klavinslab/Flexostat-hardware-firmware/README.md

# The project has moved to it's own [github page](https://github.com/flexostat ).

Please visit https://github.com/flexostat for the latest designs.

Image of Yaktocat
