klavinslab/Flexostat-hardware-firmware/led_board/seeed_BOM_File.csv

Part/Designator | Manufacture Part Number/Seeed SKU | Quantity
C1 | 0100440P1 | 1
J1 | 3420050P1 | 1
J2 | 3460650P1 | 1
ISP J5 | 3460180P1 | 2
J4 | 3460810P1 | 1
Q1 Q2 Q3 Q4 | 0440200P1 | 2
R2 R3 R4 | 301010293 | 3
U1 | 1030060P1 | 1
U2 | 310040018 | 1
D1 D2 D3 D4 D5 D6 D7 D8 | 0300040P1 | 8
