klavinslab/Flexostat-hardware-firmware/led_board/PCB_assembly_jig.stl

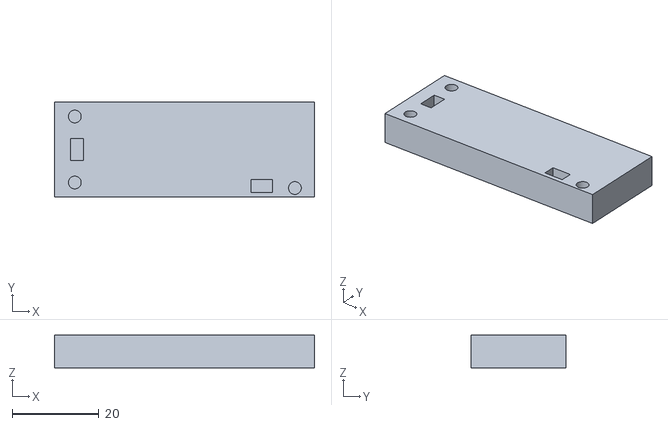
[picture p1: CAD file, 2015-09-08]
led_board/PCB_assembly_jig.stl
60.0 x 22.0 x 7.60
