klavinslab/Flexostat-hardware-firmware/chamber/chamber_25mm_tube_fan_mount.stl

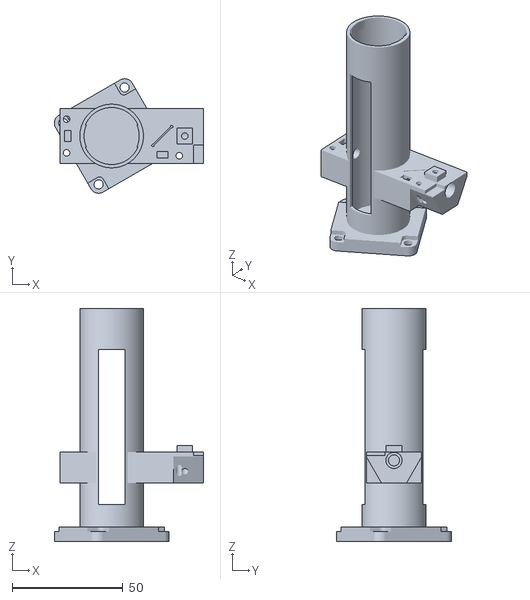
[picture p2: CAD file, 2015-09-30]
chamber/chamber_25mm_tube_fan_mount.stl
67.3 x 51.7 x 105.1
