klavinslab/Flexostat-hardware-firmware/mount/mount_plate.dxf

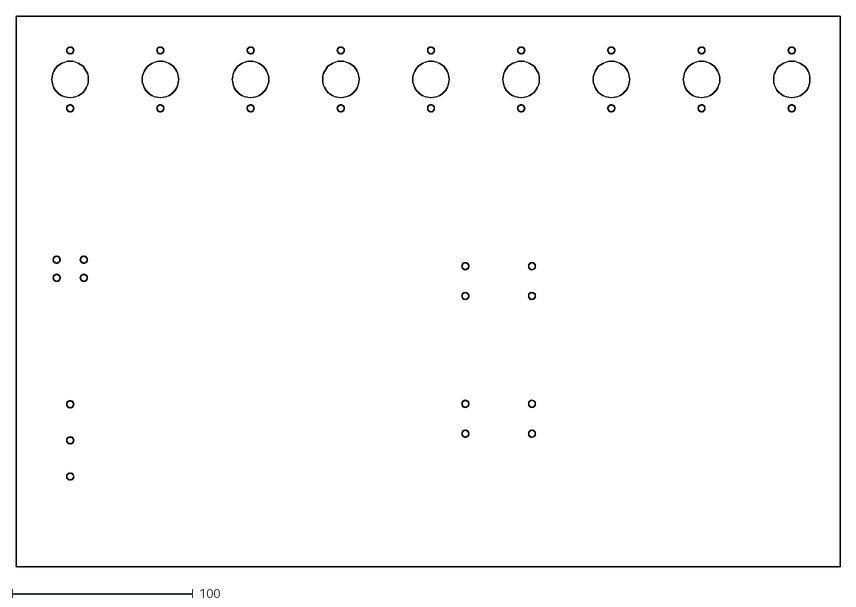
[picture p3: CAD file, 2015-09-30]
mount/mount_plate.dxf
456.0 x 304.8
