klavinslab/Flexostat-hardware-firmware/pinchvalve/Source/center_adapter.stp

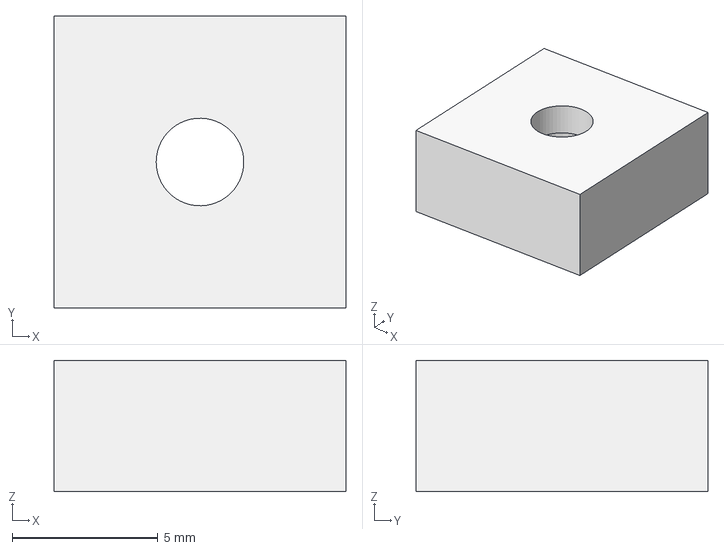
[picture p4: CAD file, 2014-01-11]
pinchvalve/Source/center_adapter.stp
10.0 x 10.0 x 4.50 mm
