klavinslab/Flexostat-hardware-firmware/stopper_mold/mold_part_1.stl

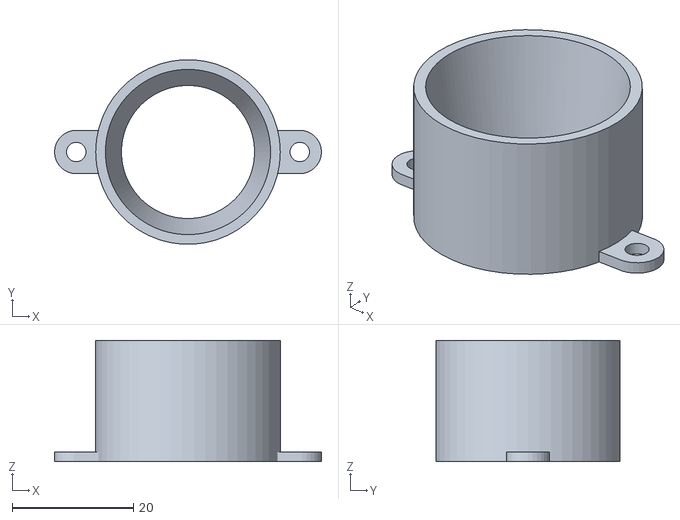
[picture p5: CAD file, 2015-09-30]
stopper_mold/mold_part_1.stl
44.0 x 30.3 x 20.0
