klavinslab/Flexostat-hardware-firmware/syringe_pump/Source/syringe_mount.stp

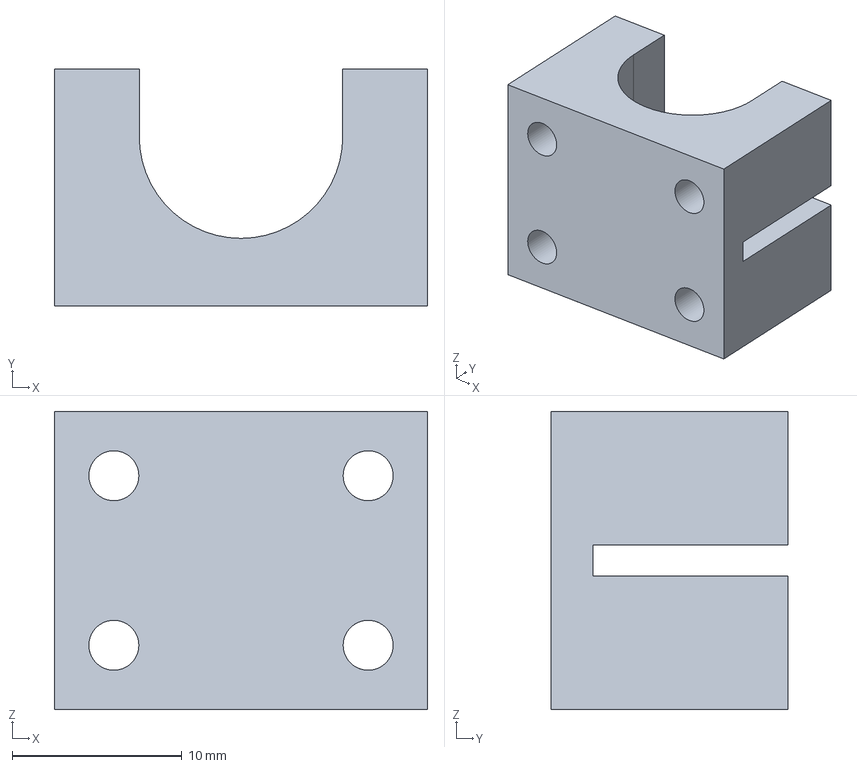
[picture p6: CAD file, 2015-04-14]
syringe_pump/Source/syringe_mount.stp
22.0 x 14.0 x 17.6 mm
