klavinslab/Flexostat-hardware-firmware/chamber/fan_magnet_holder.stl

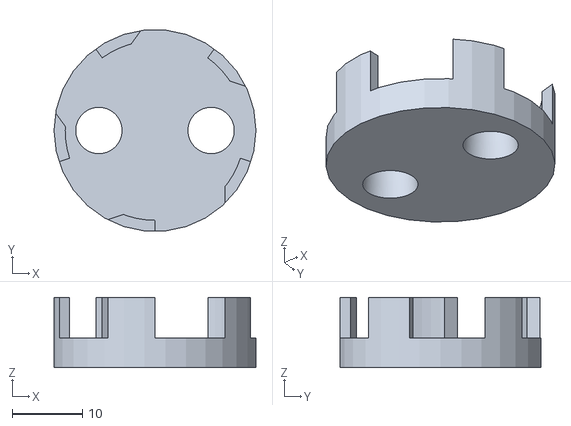
[picture p7: CAD file, 2015-09-08]
chamber/fan_magnet_holder.stl
28.8 x 28.6 x 10.0
