klavinslab/Flexostat-hardware-firmware/pinchvalve/Source/holder.stp

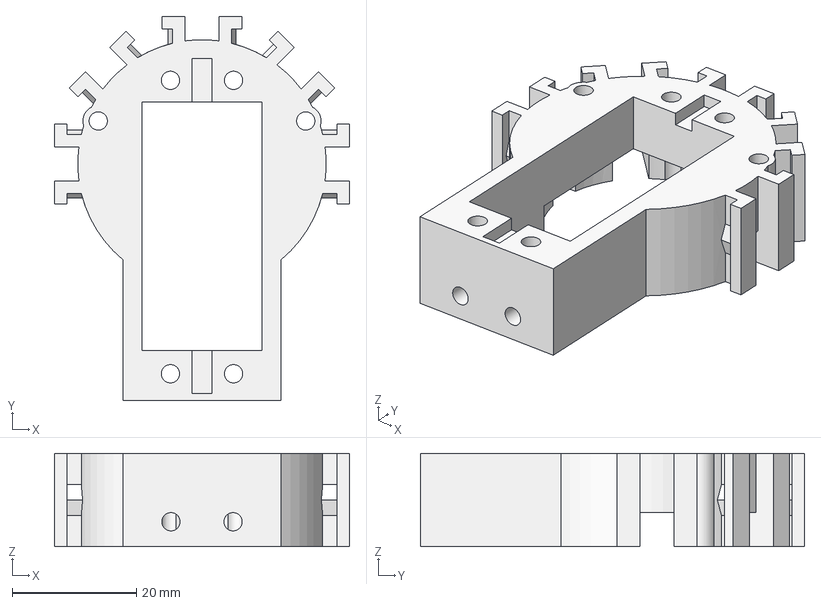
[picture p8: CAD file, 2014-01-11]
pinchvalve/Source/holder.stp
47.5 x 61.9 x 15.0 mm
