klavinslab/Flexostat-hardware-firmware/stopper_mold/mold_part_2.stl

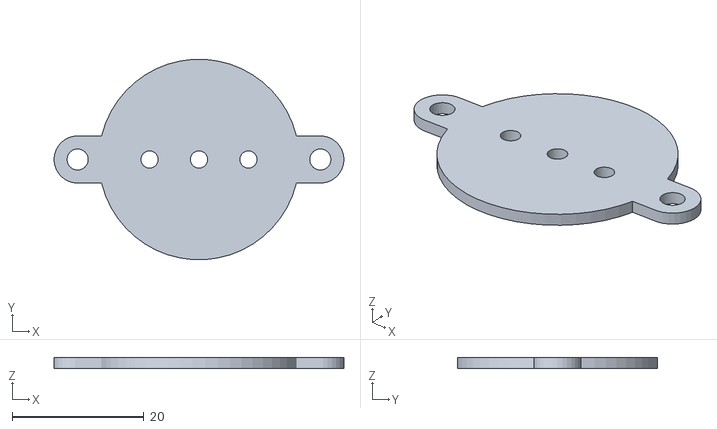
[picture p9: CAD file, 2015-09-30]
stopper_mold/mold_part_2.stl
44.0 x 30.3 x 1.60
