klavinslab/Flexostat-hardware-firmware/syringe_pump/Source/holder.stp

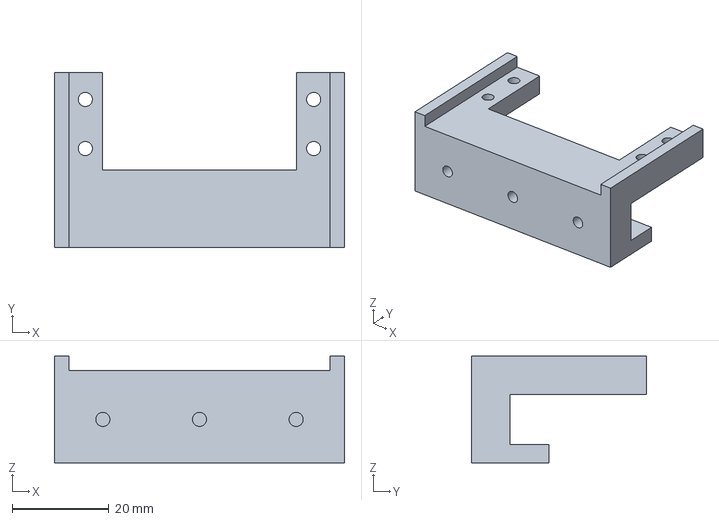
[picture p10: CAD file, 2014-08-07]
syringe_pump/Source/holder.stp
60.0 x 36.3 x 22.1 mm
