klavinslab/Flexostat-hardware-firmware/chamber/chamber_25mm_tube.stl

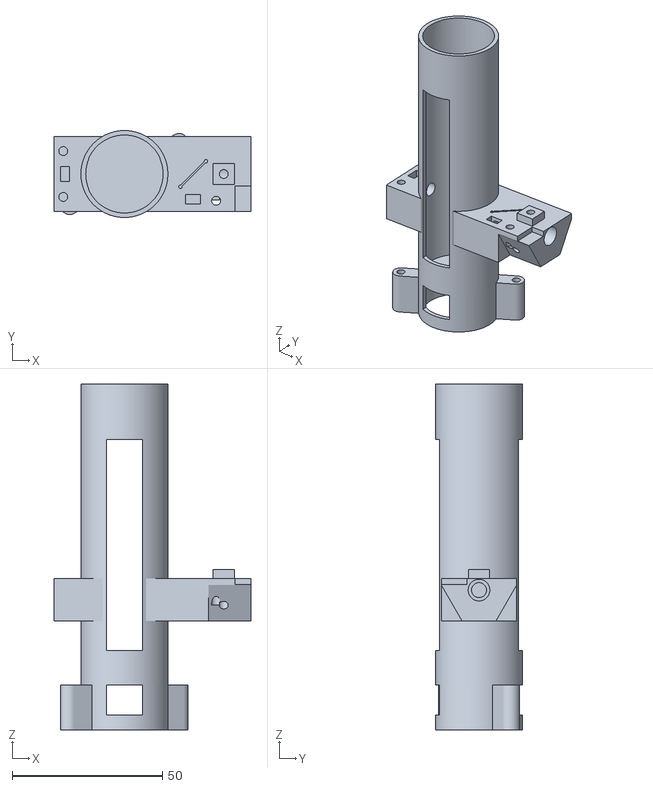
[picture p11: CAD file, 2015-08-22]
chamber/chamber_25mm_tube.stl
65.3 x 28.9 x 115.0
