klavinslab/Flexostat-hardware-firmware/pinchvalve/Source/valve_clip_1_50.stp

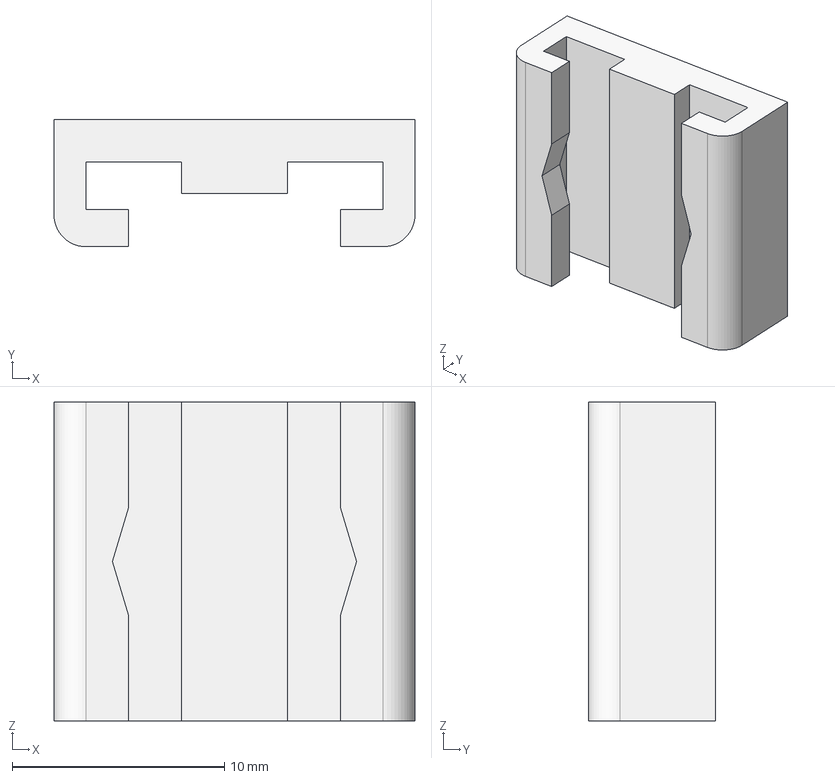
[picture p12: CAD file, 2014-01-11]
pinchvalve/Source/valve_clip_1_50.stp
17.0 x 6.00 x 15.0 mm
