klavinslab/Flexostat-hardware-firmware/stopper_mold/mold_part_3.stl

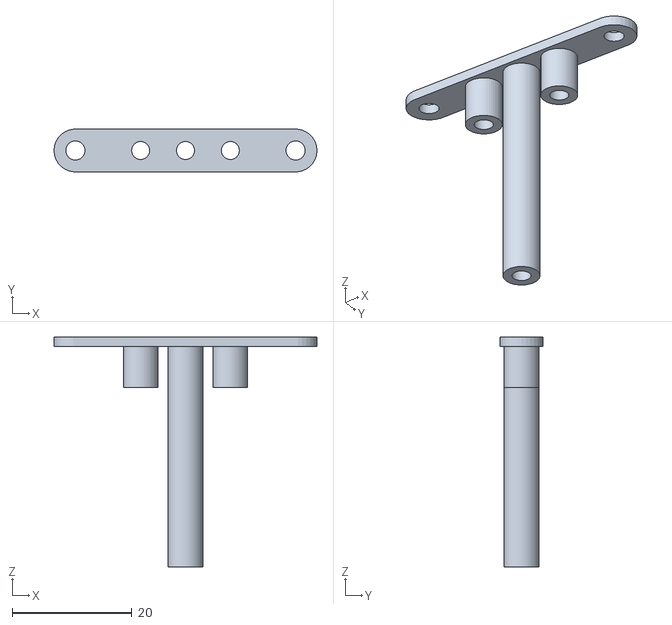
[picture p13: CAD file, 2015-09-30]
stopper_mold/mold_part_3.stl
44.0 x 7.12 x 38.4
