klavinslab/Flexostat-hardware-firmware/syringe_pump/Source/syringe_mount_top.stp

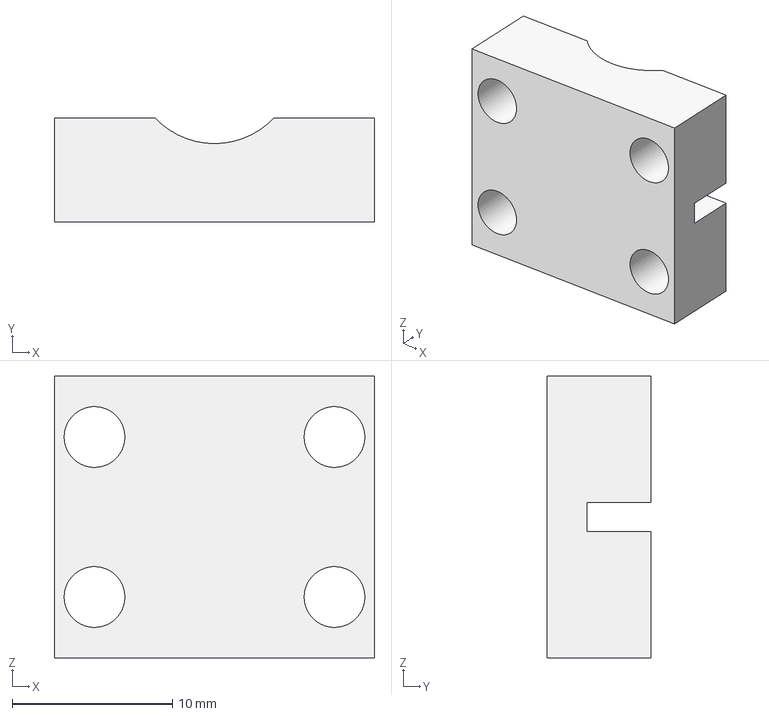
[picture p14: CAD file, 2014-01-11]
syringe_pump/Source/syringe_mount_top.stp
20.0 x 6.50 x 17.6 mm
