klavinslab/Flexostat-hardware-firmware/chamber/magnet_holder.stl

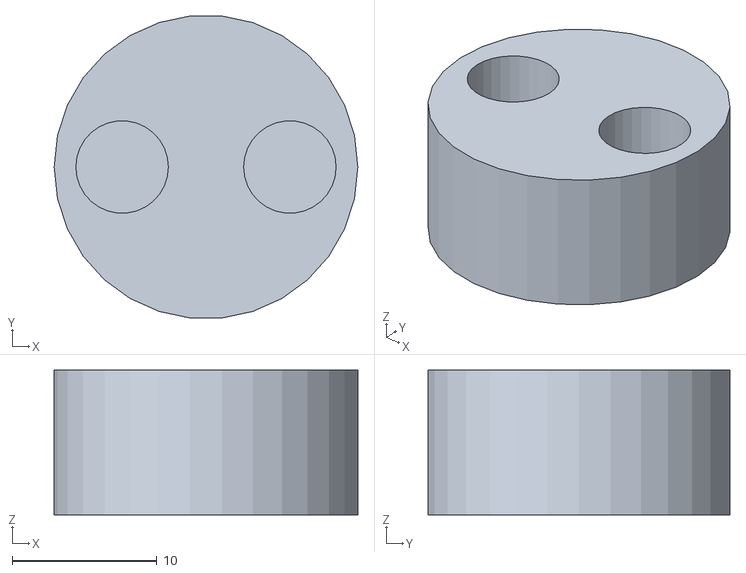
[picture p15: CAD file, 2015-08-22]
chamber/magnet_holder.stl
21.0 x 20.9 x 10.0
