klavinslab/Flexostat-hardware-firmware/stopper_mold/rubber_stopper_mold_part_AB.stl

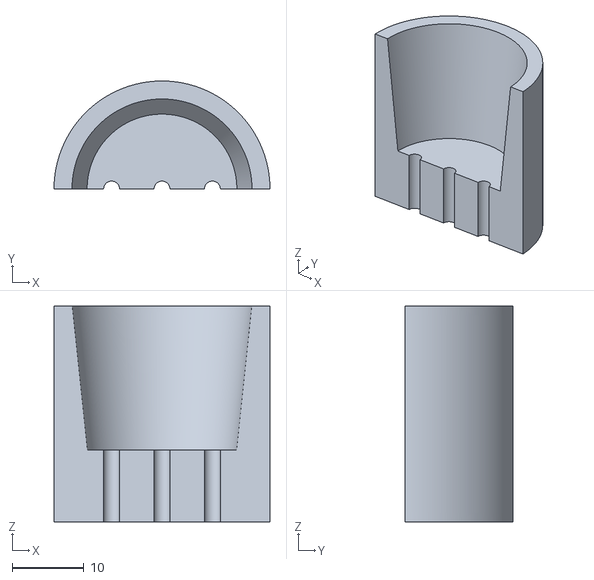
[picture p16: CAD file, 2014-11-18]
stopper_mold/rubber_stopper_mold_part_AB.stl
30.0 x 15.0 x 30.0
