klavinslab/Flexostat-hardware-firmware/syringe_pump/Source/slide.stp

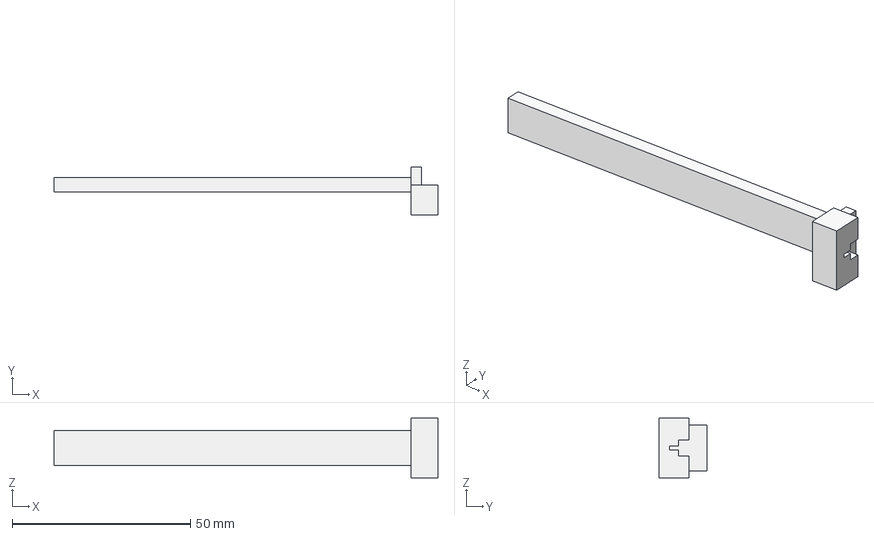
[picture p17: CAD file, 2014-01-11]
syringe_pump/Source/slide.stp
107.6 x 13.5 x 16.8 mm
