klavinslab/Flexostat-hardware-firmware/chamber/chamber_24mm_tube.stl

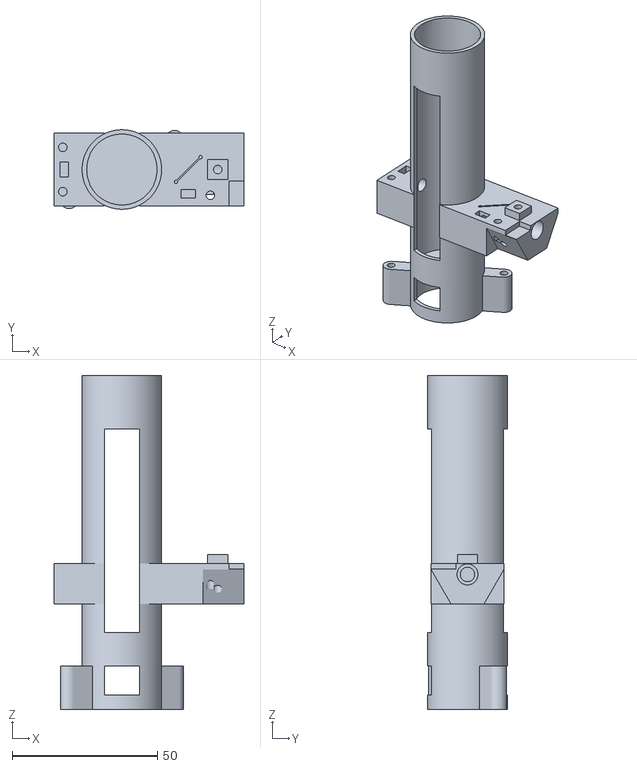
[picture p18: CAD file, 2015-08-22]
chamber/chamber_24mm_tube.stl
65.3 x 27.4 x 115.0
