klavinslab/Flexostat-hardware-firmware/stopper_mold/rubber_stopper_mold.stl

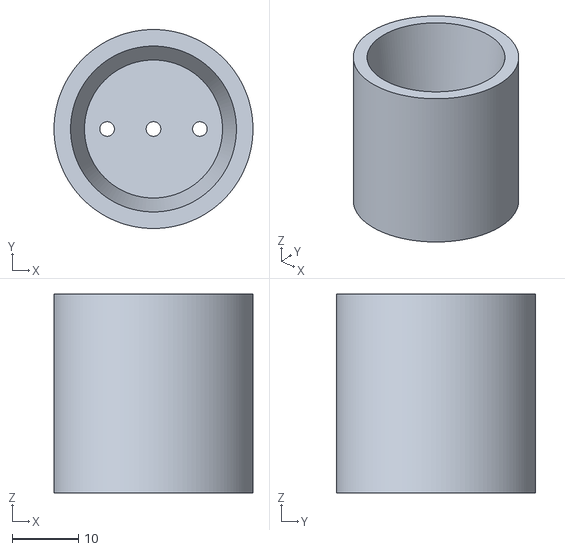
[picture p19: CAD file, 2014-01-11]
stopper_mold/rubber_stopper_mold.stl
30.0 x 30.0 x 30.0
