klavinslab/Flexostat-hardware-firmware/(list of files, cad)

Other CAD files:
pinchvalve/Source/valve_clip_2_00.stp
pinchvalve/Source/valve_clip_1_75.stp
chamber/source/PCB_assembly_jig.scad
pinchvalve/center_adapter.stl
pinchvalve/holder.stl
pinchvalve/valve_clip_1_50.stl
pinchvalve/valve_clip_1_75.stl
pinchvalve/valve_clip_2_00.stl
syringe_pump/holder.stl
syringe_pump/slide.stl
syringe_pump/syringe_mount.stl
syringe_pump/syringe_mount_top.stl
