klavinslab/Flexostat-hardware-firmware/mount/MP drawing.pdf

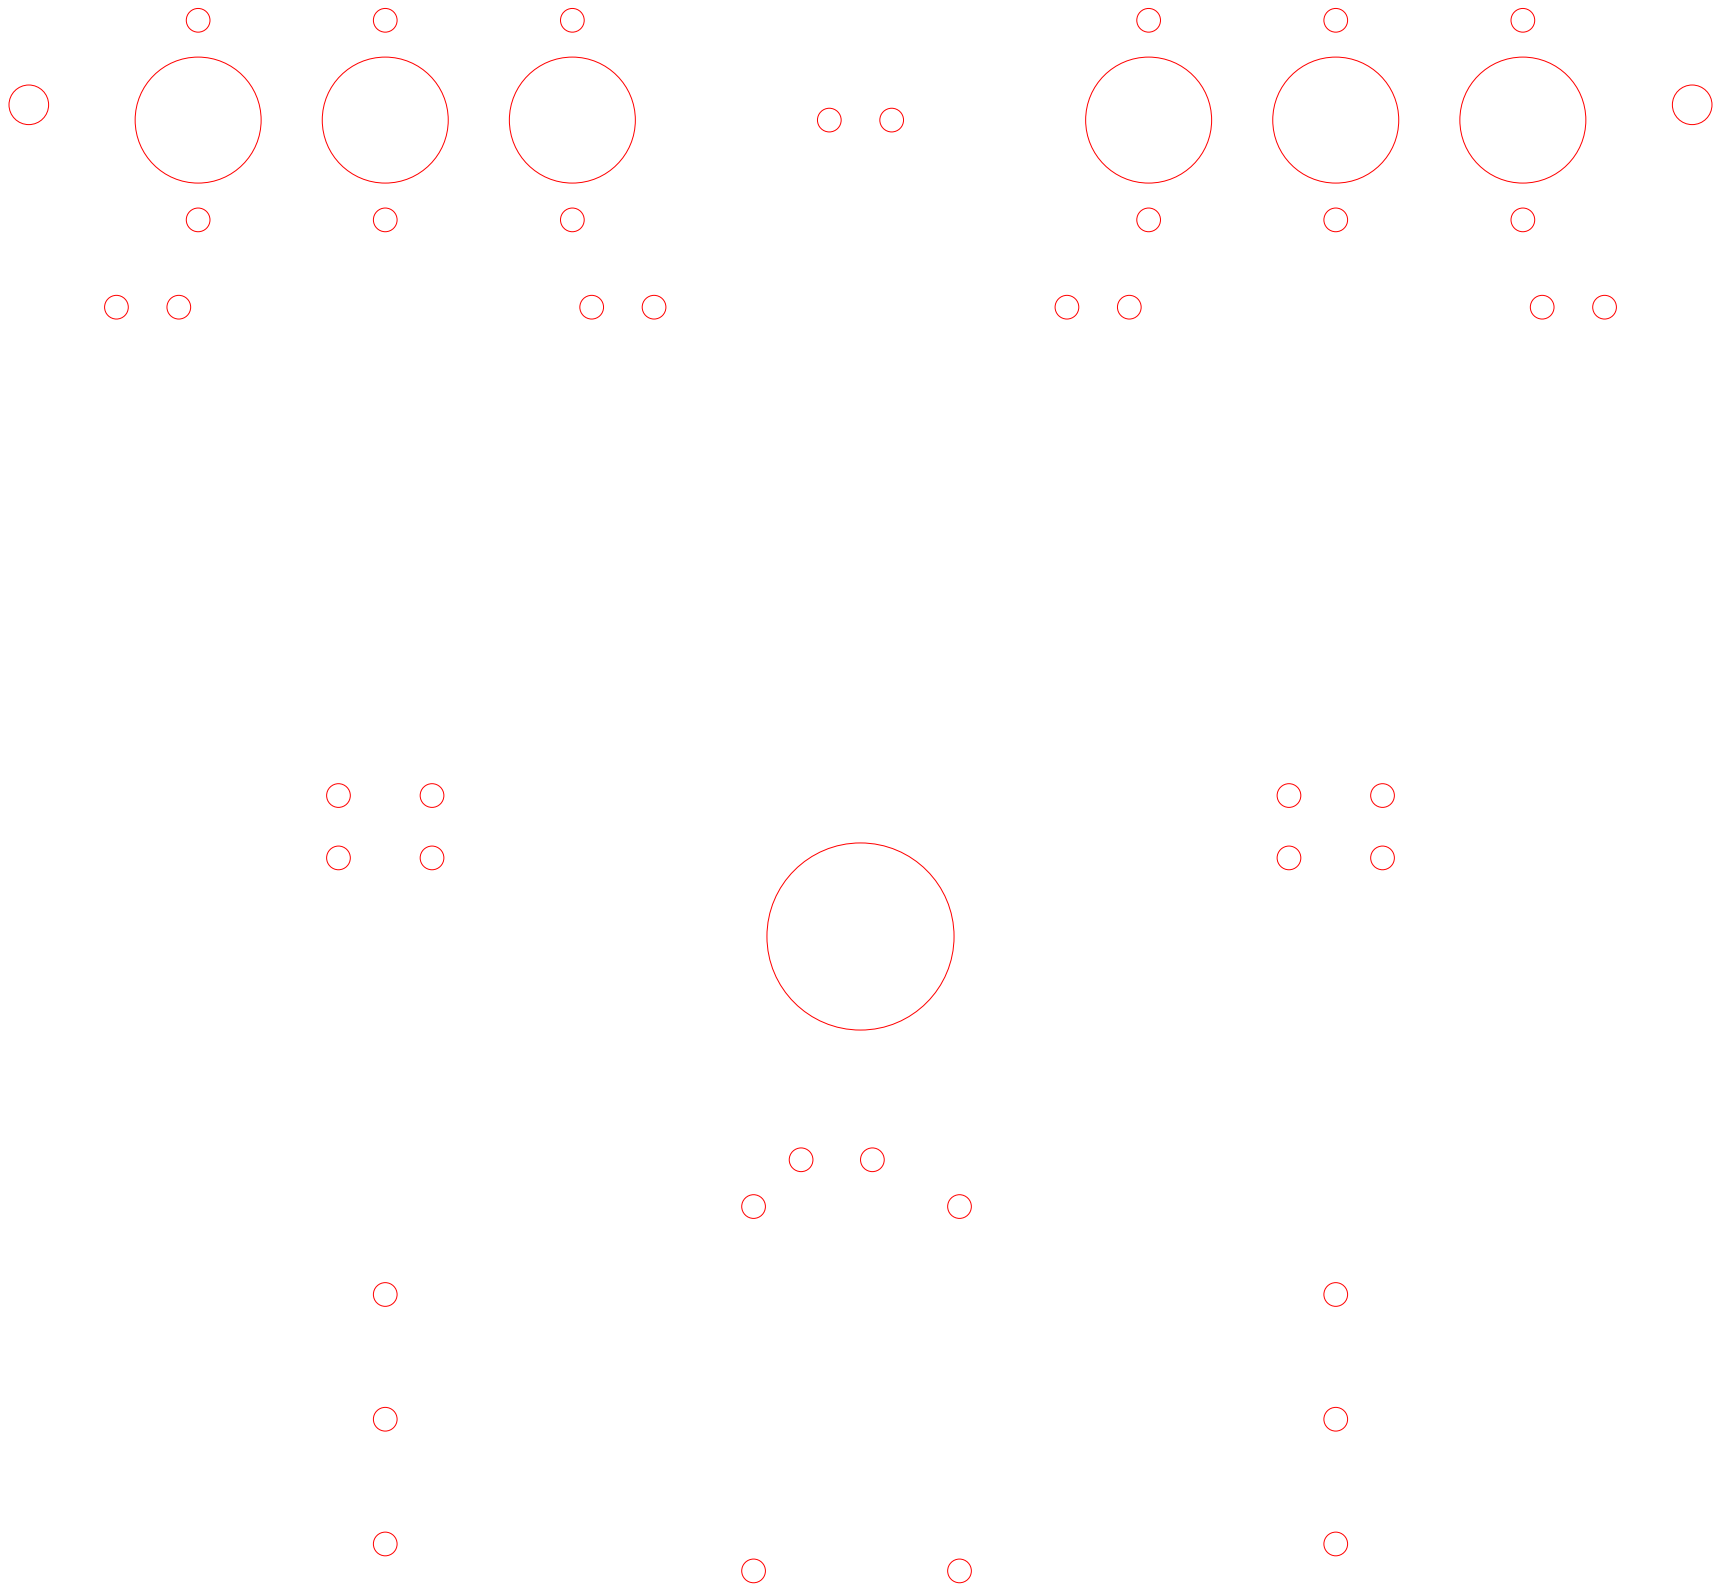
[picture p20: page 1]
