klavinslab/Flexostat-hardware-firmware/led_board/source/PCB/page1.brd

## EAGLE design led_board/source/PCB/page1.brd (2015-08-12)

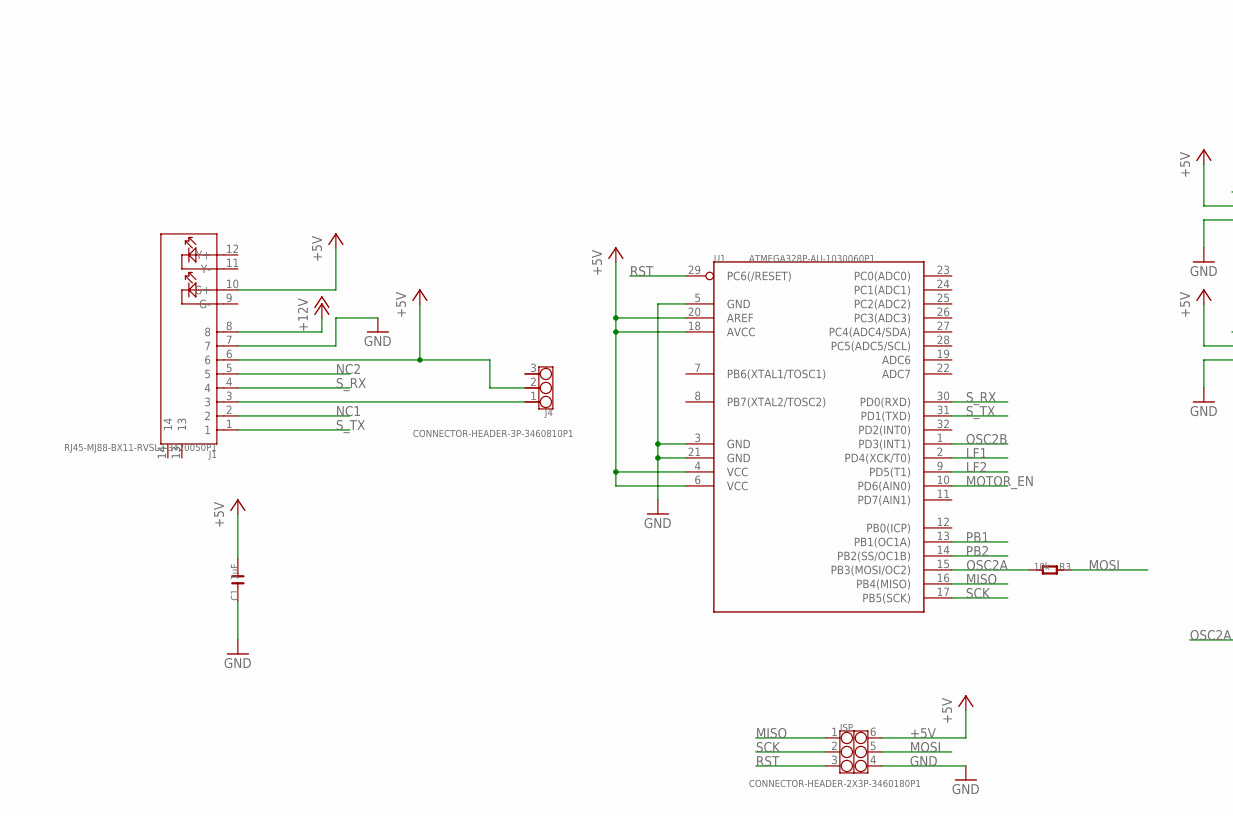
[picture p21: schematic page1.sch, part in row 1, column 1]

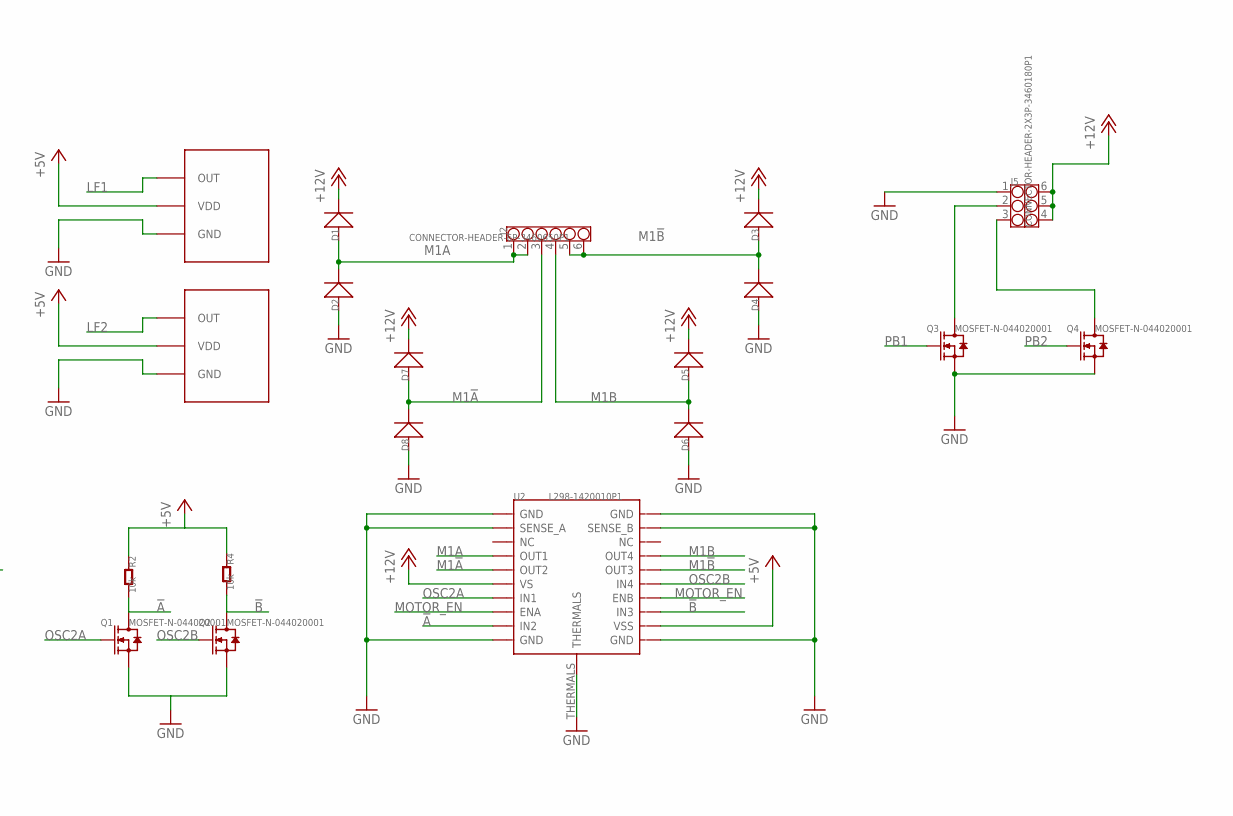
[picture p22: schematic page1.sch, part in row 1, column 2]

Parts:
C1: 1uF; C0805
D1, D2, D3, D4, D5, D6, D7, D8: D-SMA; DO-214AC
ISP: CONNECTOR-HEADER-2X3P-3460180P1; 2X3P-2.54-2.54-11.6-3.0-BLACK-MALE
J1: RJ45-MJ88-BX11-RVSL2-3420050P1; RJ45-MJ88-BX11-RVSL2
J2: CONNECTOR-HEADER-6P-3460650P1; 1X6P-2.54-2.54-11.6-3.0-BLACK-MALE
J4: CONNECTOR-HEADER-3P-3460810P1; 1X3P-2.54-2.54-11.6-3.0-BLACK-MALE
J5: CONNECTOR-HEADER-2X3P-3460180P1; 2X3P-2.54-2.54-11.6-3.0-BLACK-MALE
Q1, Q2, Q3, Q4: MOSFET-N-044020001; SOT23
R2, R3, R4: 10k; R0603
U1: ATMEGA328P-AU-1030060P1; TQFP32
U2: L298-1420010P1; POWERSO-20
U$5, U$6: TSL235; TSL235R-2MM-S

Connections:
!A: Q1.3 (D), R2.2, U2.9 (IN2)
!B: Q2.3 (D), R4.2, U2.13 (IN3)
+5V: C1.2, ISP.6, J1.6, J1.10 (G+), J4.2, R2.1, R4.1, U1.4 (VCC), U1.6 (VCC), U1.18 (AVCC), U1.20 (AREF), U2.12 (VSS), U$5.P$2 (VDD), U$6.P$2 (VDD)
+12V: D1.2 (-), D3.2 (-), D5.2 (-), D7.2 (-), J1.8, J5.4, J5.5, J5.6, U2.6 (VS)
GND: C1.1, D2.1 (+), D4.1 (+), D6.1 (+), D8.1 (+), ISP.4, J1.7, J5.1, Q1.2 (S), Q2.2 (S), Q3.2 (S), Q4.2 (S), U1.3 (GND), U1.5 (GND), U1.21 (GND), U2.1 (GND), U2.2 (SENSE_A), U2.10 (GND), U2.11 (GND), U2.19 (SENSE_B), U2.20 (GND), U2.THERMALS, U$5.P$1 (GND), U$6.P$1 (GND)
LF1: U1.2 (PD4(XCK/T0)), U$5.P$3 (OUT)
LF2: U1.9 (PD5(T1)), U$6.P$3 (OUT)
M1!A: D7.1 (+), D8.2 (-), J2.3, U2.5 (OUT2)
M1!B: D3.1 (+), D4.2 (-), J2.5, J2.6, U2.16 (OUT3)
M1A: D1.1 (+), D2.2 (-), J2.1, J2.2, U2.4 (OUT1)
M1B: D5.1 (+), D6.2 (-), J2.4, U2.17 (OUT4)
MISO: ISP.1, U1.16 (PB4(MISO))
MOSI: ISP.5, R3.1
MOTOR_EN: U1.10 (PD6(AIN0)), U2.8 (ENA), U2.14 (ENB)
unnamed: J1.3, J4.1
unnamed: J5.3, Q4.3 (D)
unnamed: J5.2, Q3.3 (D)
NC1: J1.2
NC2: J1.5
OSC2A: Q1.1 (G), R3.2, U1.15 (PB3(MOSI/OC2)), U2.7 (IN1)
OSC2B: Q2.1 (G), U1.1 (PD3(INT1)), U2.15 (IN4)
PB1: Q3.1 (G), U1.13 (PB1(OC1A))
PB2: Q4.1 (G), U1.14 (PB2(SS/OC1B))
RST: ISP.3, U1.29 (PC6(/RESET))
SCK: ISP.2, U1.17 (PB5(SCK))
S_RX: J1.4, U1.30 (PD0(RXD))
S_TX: J1.1, U1.31 (PD1(TXD))

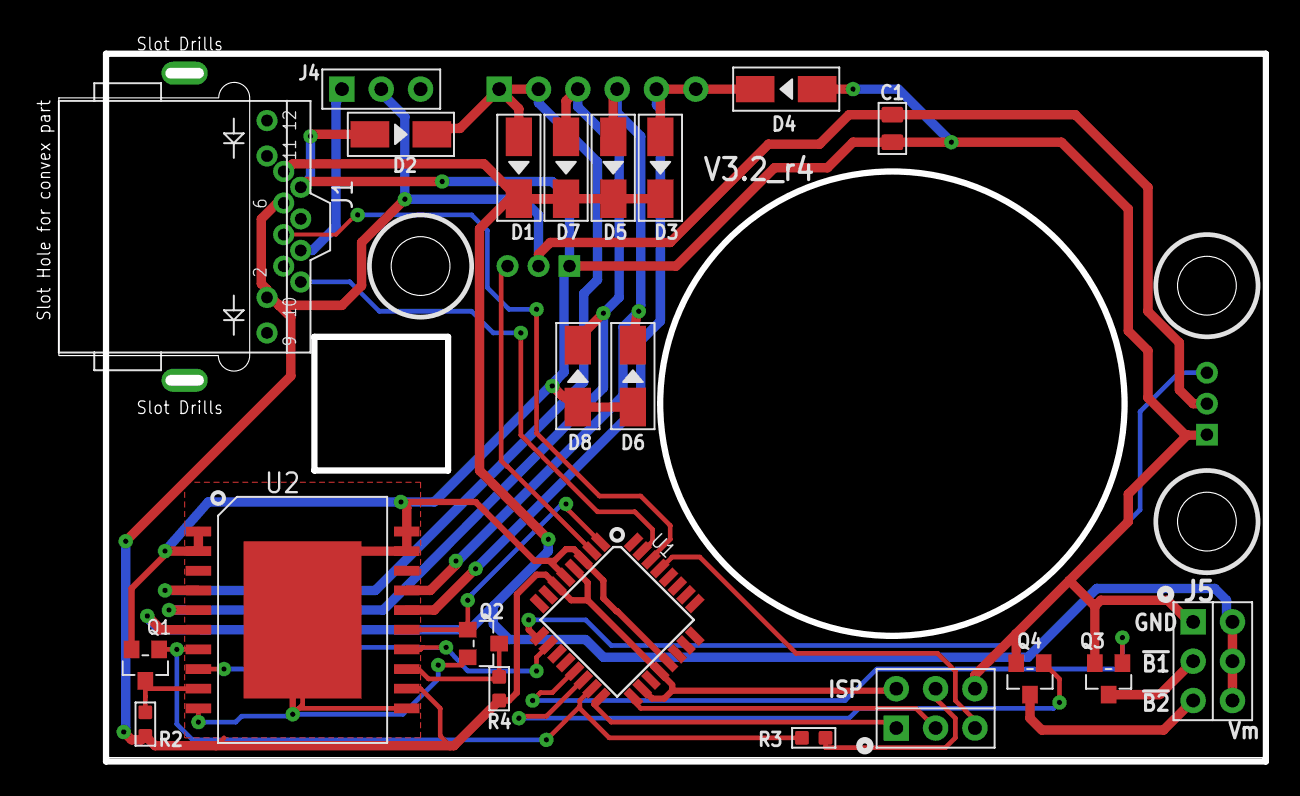
[picture p23: board page1.brd from above]

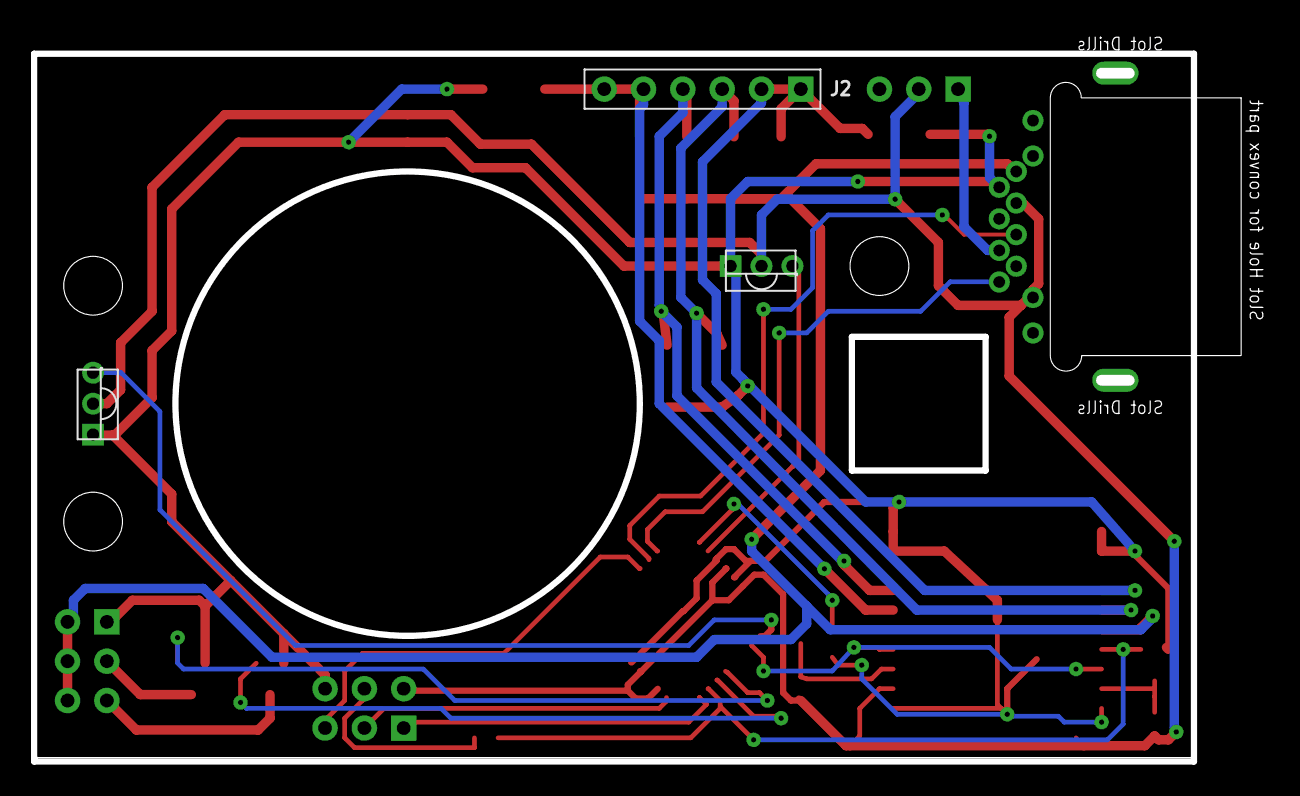
[picture p24: board page1.brd from below]

Board: 4 copper layers, 78.0 x 45.7 mm, 25 parts (3 on the bottom side), 25 nets.
