klavinslab/Flexostat-hardware-firmware/main_board/source/PCB/board.brd

## EAGLE design main_board/source/PCB/board.brd (2014-11-18)

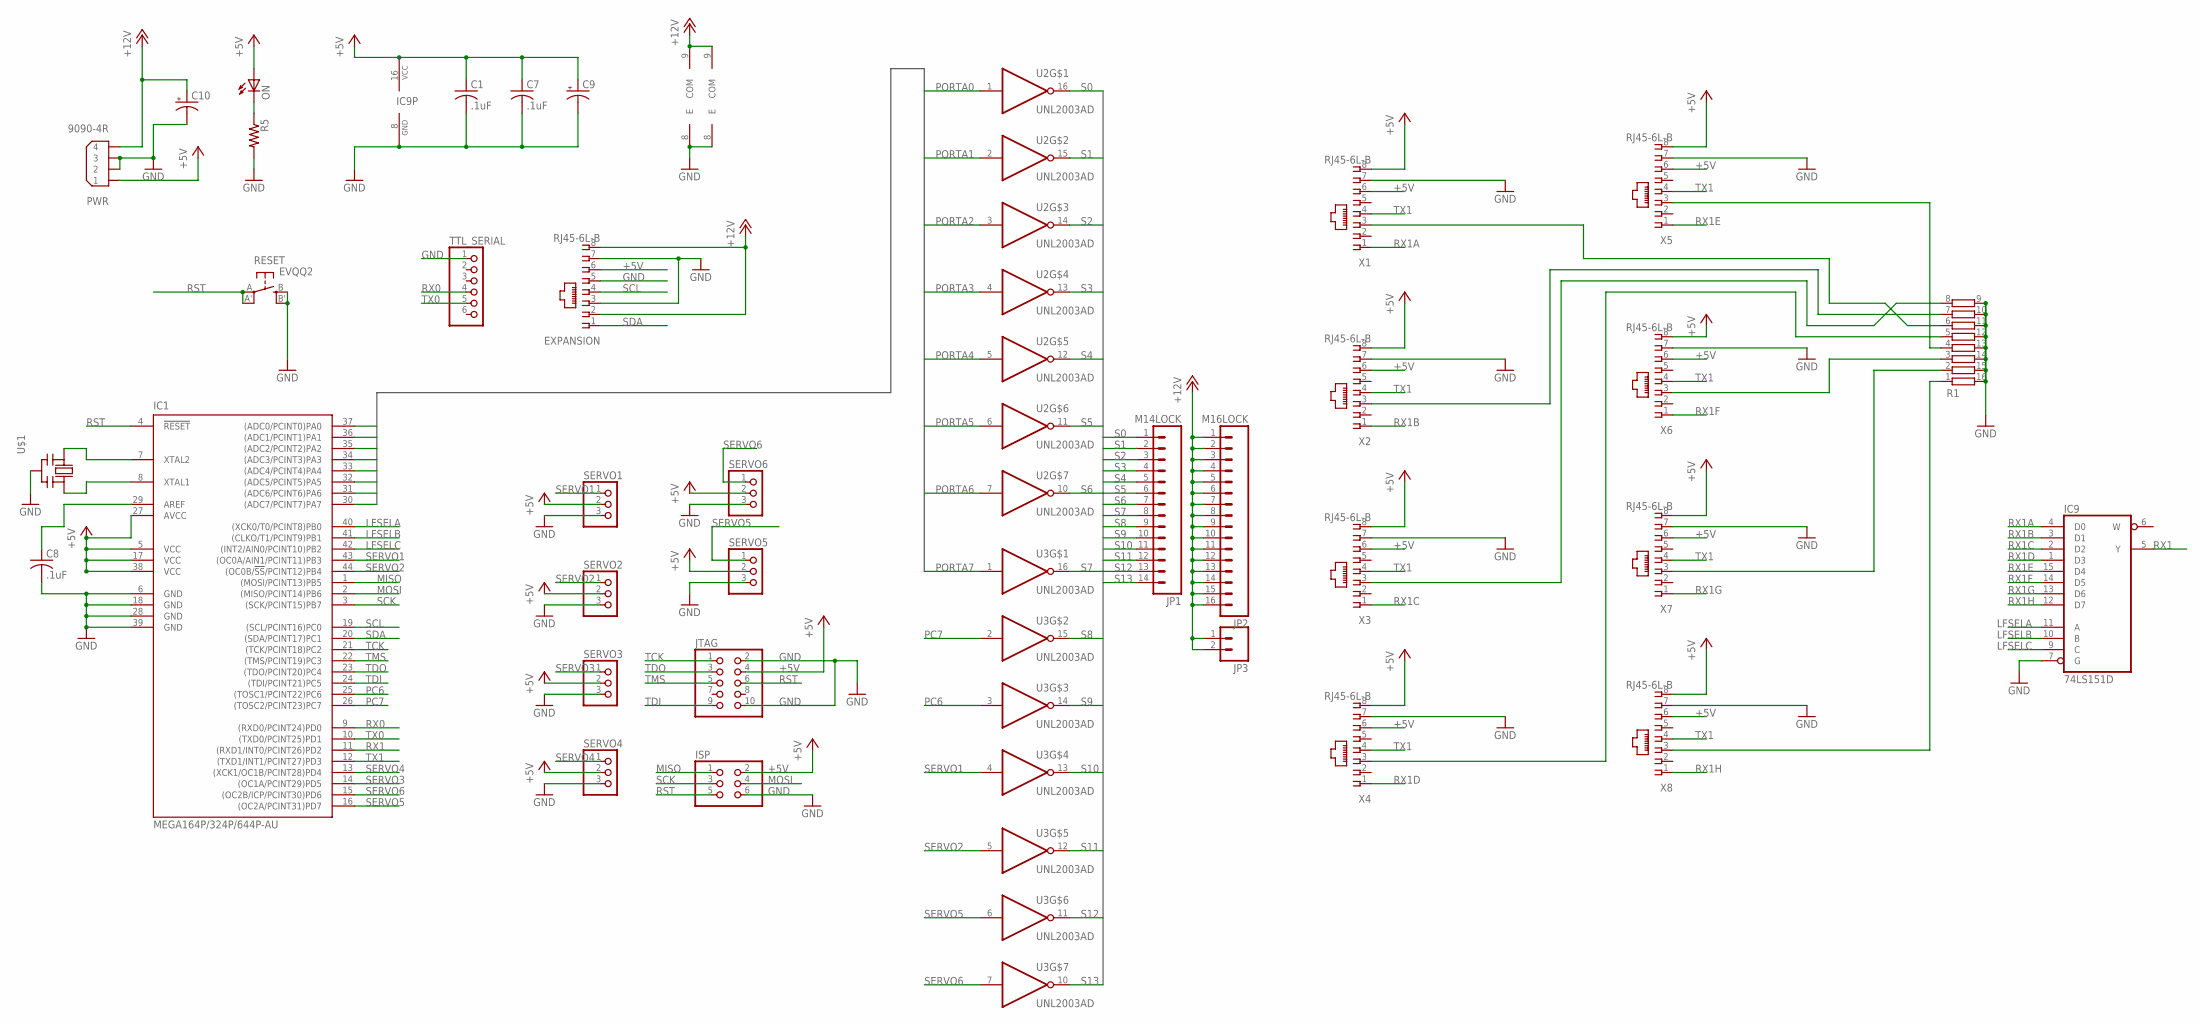
[picture p25: schematic board.sch]

Parts:
C1, C7, C8: .1uF; C0805
C9, C10: CPOL-USE2.5-7; E2,5-7
EXPANSION: RJ45-6L-B; RJ45-NO-SHIELD
IC1: MEGA164P/324P/644P-AU; TQFP44
IC9: 74LS151D; SO16
ISP: PINHD-2X3; 2X03
JP1: M14LOCK; 1X14_LOCK
JP2: M16LOCK; 1X16_LOCK
JP3: M02PTH; 1X02
JTAG: PINHD-2X5; 2X05
ON: LEDCHIPLED_0805; CHIPLED_0805
PWR: 9090-4R
R1: 2NBS16-8; SO16
R5: R-US_R0805; R0805
RESET: EVQQ2; EVQ-Q2
SERVO1, SERVO2, SERVO3, SERVO4, SERVO5, SERVO6: PINHD-1X3; 1X03
TTL_SERIAL: PINHD-1X6; 1X06
U2, U3: UNL2003AD; SO16
U$1: CERMOSCILL-CSTCRG; CSTCR-G
X1, X2, X3, X4, X5, X6, X7, X8: RJ45-6L-B; RJ45-NO-SHIELD

Connections:
+5V: C1.1, C7.1, C9.+, EXPANSION.6, IC1.5 (VCC), IC1.17 (VCC), IC1.27 (AVCC), IC1.38 (VCC), IC9.16 (VCC), ISP.2, JTAG.4, ON.A, PWR.1, SERVO1.2, SERVO2.2, SERVO3.2, SERVO4.2, SERVO5.2, SERVO6.2, X1.6, X1.8, X2.6, X2.8, X3.6, X3.8, X4.6, X4.8, X5.6, X5.8, X6.6, X6.8, X7.6, X7.8, X8.6, X8.8
+12V: C10.+, EXPANSION.2, EXPANSION.8, JP2.1, JP2.2, JP2.3, JP2.4, JP2.5, JP2.6, JP2.7, JP2.8, JP2.9, JP2.10, JP2.11, JP2.12, JP2.13, JP2.14, JP2.15, JP2.16, JP3.1, JP3.2, PWR.4, U2.9 (COM), U3.9 (COM)
GND: C1.2, C7.2, C8.2, C9.-, C10.-, EXPANSION.3, EXPANSION.5, EXPANSION.7, IC1.6 (GND), IC1.18 (GND), IC1.28 (GND), IC1.39 (GND), IC9.7 (G), IC9.8 (GND), ISP.6, JTAG.2, JTAG.10, PWR.2, PWR.3, R1.9, R1.10, R1.11, R1.12, R1.13, R1.14, R1.15, R1.16, R5.2, RESET.B (S), RESET.B' (S1), SERVO1.3, SERVO2.3, SERVO3.3, SERVO4.3, SERVO5.3, SERVO6.3, TTL_SERIAL.1, U2.8 (E), U3.8 (E), U$1.2 (GND), X1.7, X2.7, X3.7, X4.7, X5.7, X6.7, X7.7, X8.7
LFSELA: IC1.40 ((XCK0/T0/PCINT8)PB0), IC9.11 (A)
LFSELB: IC1.41 ((CLKO/T1/PCINT9)PB1), IC9.10 (B)
LFSELC: IC1.42 ((INT2/AIN0/PCINT10)PB2), IC9.9 (C)
MISO: IC1.1 ((MOSI/PCINT13)PB5), ISP.1
MOSI: IC1.2 ((MISO/PCINT14)PB6), ISP.4
unnamed: IC1.7 (XTAL2), U$1.1 (IN)
unnamed: IC1.8 (XTAL1), U$1.3 (OUT)
unnamed: R1.1, X8.3
unnamed: R1.6, X1.3
unnamed: R1.7, X2.3
unnamed: R1.8, X3.3
unnamed: R1.5, X4.3
unnamed: R1.4, X5.3
unnamed: R1.3, X6.3
unnamed: R1.2, X7.3
unnamed: C8.1, IC1.29 (AREF)
unnamed: ON.C, R5.1
PC6: IC1.25 ((TOSC1/PCINT22)PC6), U3.3 (I)
PC7: IC1.26 ((TOSC2/PCINT23)PC7), U3.2 (I)
PORTA0: IC1.37 ((ADC0/PCINT0)PA0), U2.1 (I)
PORTA1: IC1.36 ((ADC1/PCINT1)PA1), U2.2 (I)
PORTA2: IC1.35 ((ADC2/PCINT2)PA2), U2.3 (I)
PORTA3: IC1.34 ((ADC3/PCINT3)PA3), U2.4 (I)
PORTA4: IC1.33 ((ADC4/PCINT4)PA4), U2.5 (I)
PORTA5: IC1.32 ((ADC5/PCINT5)PA5), U2.6 (I)
PORTA6: IC1.31 ((ADC6/PCINT6)PA6), U2.7 (I)
PORTA7: IC1.30 ((ADC7/PCINT7)PA7), U3.1 (I)
RST: IC1.4 (!RESET), ISP.5, JTAG.6, RESET.A, RESET.A' (P1)
RX0: IC1.9 ((RXD0/PCINT24)PD0), TTL_SERIAL.4
RX1: IC1.11 ((RXD1/INT0/PCINT26)PD2), IC9.5 (Y)
RX1A: IC9.4 (D0), X1.1
RX1B: IC9.3 (D1), X2.1
RX1C: IC9.2 (D2), X3.1
RX1D: IC9.1 (D3), X4.1
RX1E: IC9.15 (D4), X5.1
RX1F: IC9.14 (D5), X6.1
RX1G: IC9.13 (D6), X7.1
RX1H: IC9.12 (D7), X8.1
S0: JP1.1, U2.16 (O)
S1: JP1.2, U2.15 (O)
S2: JP1.3, U2.14 (O)
S3: JP1.4, U2.13 (O)
S4: JP1.5, U2.12 (O)
S5: JP1.6, U2.11 (O)
S6: JP1.7, U2.10 (O)
S7: JP1.8, U3.16 (O)
S8: JP1.9, U3.15 (O)
S9: JP1.10, U3.14 (O)
S10: JP1.11, U3.13 (O)
S11: JP1.12, U3.12 (O)
S12: JP1.13, U3.11 (O)
S13: JP1.14, U3.10 (O)
SCK: IC1.3 ((SCK/PCINT15)PB7), ISP.3
SCL: EXPANSION.4, IC1.19 ((SCL/PCINT16)PC0)
SDA: EXPANSION.1, IC1.20 ((SDA/PCINT17)PC1)
SERVO1: IC1.43 ((OC0A/AIN1/PCINT11)PB3), SERVO1.1, U3.4 (I)
SERVO2: IC1.44 ((OC0B/!SS!/PCINT12)PB4), SERVO2.1, U3.5 (I)
SERVO3: IC1.14 ((OC1A/PCINT29)PD5), SERVO3.1
SERVO4: IC1.13 ((XCK1/OC1B/PCINT28)PD4), SERVO4.1
SERVO5: IC1.16 ((OC2A/PCINT31)PD7), SERVO5.1, U3.6 (I)
SERVO6: IC1.15 ((OC2B/ICP/PCINT30)PD6), SERVO6.1, U3.7 (I)
TCK: IC1.21 ((TCK/PCINT18)PC2), JTAG.1
TDI: IC1.24 ((TDI/PCINT21)PC5), JTAG.9
TDO: IC1.23 ((TDO/PCINT20)PC4), JTAG.3
TMS: IC1.22 ((TMS/PCINT19)PC3), JTAG.5
TX0: IC1.10 ((TXD0/PCINT25)PD1), TTL_SERIAL.5
TX1: IC1.12 ((TXD1/INT1/PCINT27)PD3), X1.4, X2.4, X3.4, X4.4, X5.4, X6.4, X7.4, X8.4

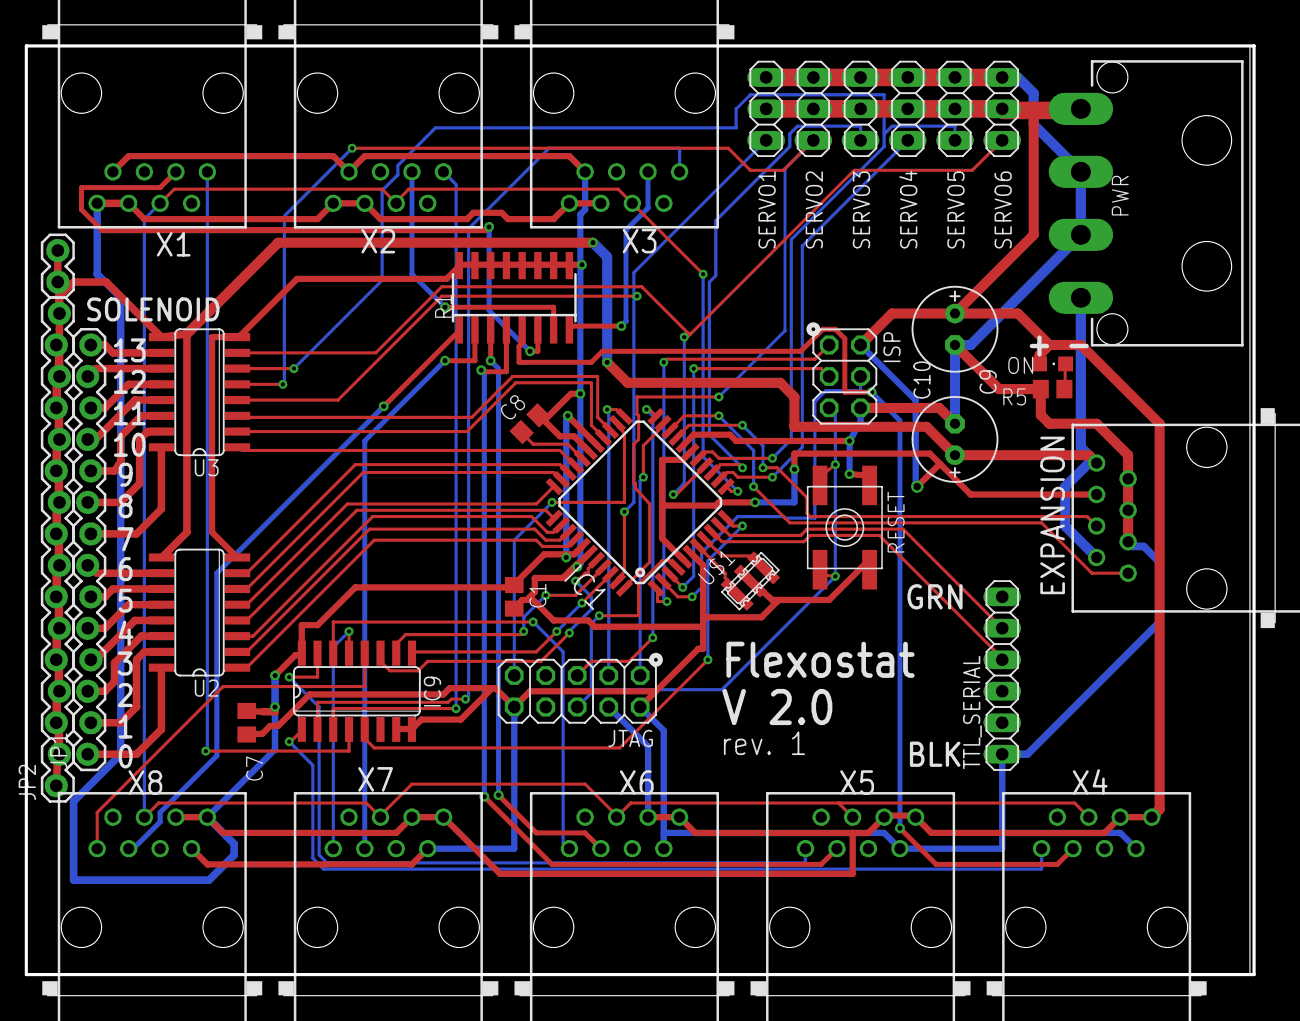
[picture p26: board board.brd from above]

Board: 2 copper layers, 100.8 x 78.3 mm, 36 parts (0 on the bottom side), 70 nets.
