klavinslab/Flexostat-hardware-firmware/led_board/source/firmware/pwm.c

/*
 * pwm.c
 *
 * Created: 8/2/2011 3:10:29 PM
 *  Author: soslab
 */ 
#include "pwm.h"
#include <avr/io.h>
#include <avr/interrupt.h>

volatile uint16_t epocht;
volatile uint16_t millist;

//setup stir motor PWM
//TODO: convert this to work with timer2
void pwm_init() {
	/******STIR INIT*******/
#if defined(__AVR_ATmega328P__) || defined(__AVR_ATmega328__)
	DDRB |= 0x08; //PB3:OSC2A output
	DDRD |= 0x08; //PD3:OSC2B output
#elif defined(__AVR_ATmega164A__) || defined(__AVR_ATmega164P__)
	DDRD |= 0x80 | 0x40;
#else
#error "UNSUPPORTED arcitecture.  Cannot continue"
#endif	
	
	//CTC mode, toggle on compare match A, B
	TCCR2A = 0x02 | 0x40 | 0x10;
	//cksel /1024, 
	TCCR2B = 0x07;
	
	//toggle on couter top and half counter top to create 90deg phase
	OCR2A = COUNTER_TOP;
	OCR2B = COUNTER_TOP/2;
	
	TIMSK2 = 1<<OCIE2A; 
	epocht = 0;
	
}

//one epoch is 2/STIR_SPEED seconds
ISR (TIMER2_COMPA_vect) {
	epocht++;	
  millist += (2000L/STIR_SPEED);
}

//this is a low res estimate of current time
// it is roughly 2/STIR_SPEED of a second accurate.
// ie for STIR_SPEED=400 it is accurate to +/- 5 millis
// Over flows ever minute or so.
// Note: millis will be off if 2000L/STIR_SPEED has a remainder.
uint16_t millis() {
  return millist;
}

uint16_t epoch() {
	return epocht;
}
