klavinslab/Flexostat-hardware-firmware/(commit log)

2012-11-03 First commit of turbidostat 1.0 hardware and firmware files
    [board.brd, board.sch]
2013-08-05 updated chamber. raised laser height to avoid catching stirbar. reworked laser holder, should be a lot more accurate and secure. version number 7.
2013-08-06 added stl files
    [chamber.stl, magnet holder.stl, motor mount.stl]
2014-01-11 tweaked file names to remove spaces
    [magnet_holder.stl, motor_mount.stl, rubber_stopper_mold.stl, rubber_stopper_mold.stp]
2014-01-11 added step and stl versions of all 3d parts
    also added different sized pinch valves clips.
    [center_adapter.stl, center_adapter.stp, chamber.stl, chamber.stp, holder.stl, holder.stp, magnet_holder.stl, magnet_holder.stp]
2014-03-18 added eagle files for LED board. version 3.1
    [page1.brd, page1.sch]
2014-03-18 updated to version 3.2 of led PCB
    [page1.brd, page1.sch]
2014-03-19 added BOM file for ordering LED board from seeed studio preassembled
    [seeed_BOM_File.csv]
2014-03-19 added error check at complie time
    [pwm.c]
2014-04-04 added support for LED board version 3.2
2014-04-04 Updated PCB design for ledboard 3.2r1
    [page1.GBL, page1.GBO, page1.GBP, page1.GBS, page1.GTL, page1.GTO, page1.GTP, page1.GTS]
2014-04-04 updated chamber design to accomidate the new motor
    [magnet_holder.stl, magnet_holder.stp, motor_mount.stl, motor_mount.stp]
2014-05-13 reorg directory structure
    [chamber.stp, magnet_holder.stp, motor_mount.stp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]
2014-05-13 more file reorg
    [page1.GBL, page1.GBO, page1.GBP, page1.GBS, page1.GTL, page1.GTO, page1.GTP, page1.GTS]
2014-05-13 updated c code to reflect new boards. included hex file
2014-05-13 updated directory structure and added binaries
    [board.GBL, board.GBO, board.GBP, board.GBS, board.GTL, board.GTO, board.GTP, board.GTS]
2014-05-13 more directory reorg
    [rubber_stopper_mold.stp]
2014-05-13 last directory rework
    [holder.stp, slide.stp, syringe_mount.stp, syringe_mount_top.stp]
2014-08-07 update to syringe pump. More robust with black plastic. easier to assemble
    [holder.stl, holder.stp]
2014-08-07 LED board update rev3. Vs and Vss corrected
    [page1.brd, page1.sch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]
2014-08-13 update mount for mainboard v2.0
2014-11-18 made a 2-part stopper mold for easy removal
    [rubber_stopper_mold_part_AB.stl]
2014-11-18 added a full chamber assembly for printing on SLS printers
    [Chamber_full_assembly.stl]
2014-11-18 udptade to FLEXOSTAT V2.0
    [board.GBL, board.GBO, board.GBP, board.GBS, board.GTL, board.GTO, board.GTP, board.GTS]
2014-11-18 fixed overlay layer. SPV numbers now line up with pins
    [board.GTO]
2014-12-18 tightened tolerances
    [center_adapter.stl]
2014-12-19 millis now counts the full range of uint16_t.
2014-12-19 now pulls enable pin high for stirring on newest board rev
2015-04-14 small firmware but where chamber 8 wouldn't close under some circumstances
2015-04-14 minor chamber update
    [chamber.stl]
2015-04-14 updated syringe body holder. top no longer needed!
    [syringe_mount.stl, syringe_mount.stp]
2015-04-17 basic i2c support
2015-04-17 i2c PV support
2015-08-12 added control over stirrer driver OE
    [page1.brd, page1.sch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]
2015-08-12 updated bom file for seeed's new format
    [seeed_BOM_File.csv]
2015-08-21 experimental new designs
    [chamber_25mm_tube.stl]
2015-08-22 switched to openSCAD. These designs should work!
    [Chamber_full_assembly.stl, chamber.scad, chamber.stl, chamber.stp, chamber_24mm_tube.stl, chamber_25mm_tube.stl, magnet_holder.scad, magnet_holder.stl]
2015-08-25 new stopper mold. 3 parts.
    [mold.scad, mold_part_1.stl, mold_part_2.stl, mold_part_3.stl, rubber_stopper_mold.stp]
2015-08-28 fixed bom to align with seeed's new partnumber
    [seeed_BOM_File.csv]
2015-08-29 working for 25mm tubes, printing at .3mm layers
    [chamber.scad, chamber_25mm_tube_fan_mount.stl]
2015-08-30 holes go all the way through
    [chamber.scad]
2015-09-08 magnet holder
    [fan_magnet_holder.scad]
2015-09-08 soldering jig
    [PCB_assembly_jig.scad, PCB_assembly_jig.stl, fan_magnet_holder.stl]
2015-09-24 parameter updates (working)
    [chamber.scad]
2015-09-24 recessed screws
    [chamber.scad]
2015-09-30 fixed unit conversion 24.5->25.4
    [mount_plate.scad]
2015-09-30 update stls
    [chamber_25mm_tube_fan_mount.stl, mold_part_1.stl, mold_part_2.stl, mold_part_3.stl]
2015-09-30 updated mount plate width
    [mount_plate.dxf]
2015-09-30 fixed partnumber changed by seeed
    [seeed_BOM_File.csv]
